nbelzer/Split-Flap-Display/pcb/SplitFlap.kicad_pcb

## KiCad design pcb/SplitFlap.kicad_pcb (2026-03-01)

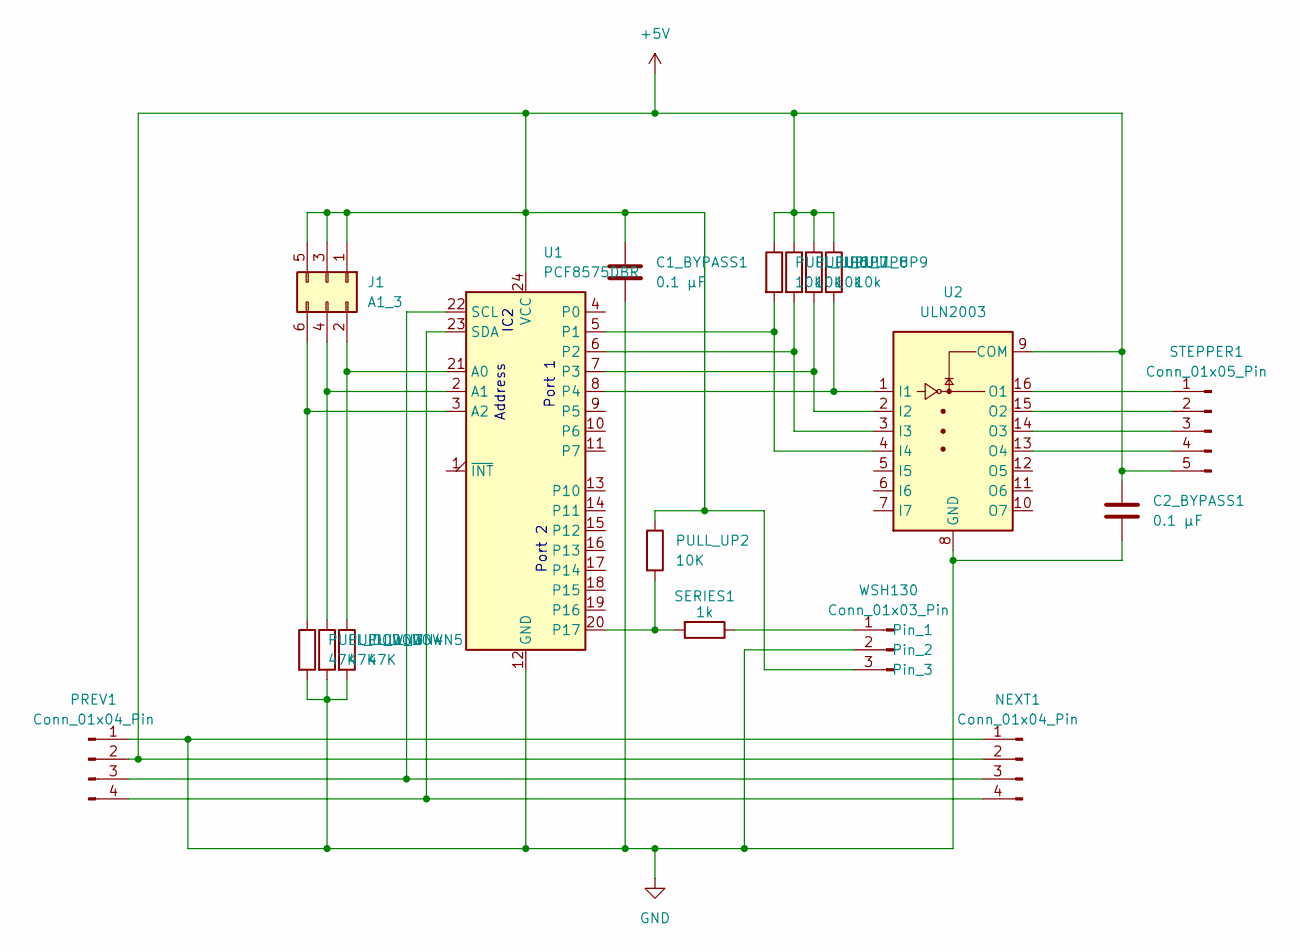
[picture p1: schematic SplitFlap.kicad_sch]

Parts:
C1_BYPASS1, C2_BYPASS1: 0.1 µF; C_0402_1005Metric; MPN C1525
J1: A1_3; PinHeader_2x03_P2.54mm_Vertical; MPN C7501594
NEXT1: Conn_01x04_Pin; PinSocket_1x04_P2.54mm_Horizontal; MPN C2897386
PREV1: Conn_01x04_Pin; PinHeader_1x04_P2.54mm_Horizontal; MPN C91552
PULL_DOWN3, PULL_DOWN4, PULL_DOWN5: 47K; R_0603_1608Metric; MPN C25600
PULL_UP2: 10K; R_0603_1608Metric; MPN C73809
PULL_UP6, PULL_UP7, PULL_UP8, PULL_UP9: 10k; R_0603_1608Metric; MPN C73809
SERIES1: 1k; R_0603_1608Metric; MPN C14676
STEPPER1: Conn_01x05_Pin; JST_XH_S5B-XH-A_1x05_P2.50mm_Horizontal; MPN C263757
U1: PCF8575DBR; SSOP-24_5.3x8.2mm_P0.65mm; MPN C2863388
U2: ULN2003; SOIC-16_3.9x9.9mm_P1.27mm; MPN C61273
WSH130: Conn_01x03_Pin; JST_PH_B3B-PH-K_1x03_P2.00mm_Vertical; MPN C2320

Connections:
+5V: C1_BYPASS1.1, C2_BYPASS1.2, J1.1, J1.3, J1.5, NEXT1.2, PREV1.2, PULL_UP2.1, PULL_UP6.1, PULL_UP7.1, PULL_UP8.1, PULL_UP9.1, STEPPER1.5, U1.24 (VCC), U2.9 (COM), WSH130.3
GND: C1_BYPASS1.2, C2_BYPASS1.1, NEXT1.1, PREV1.1, PULL_DOWN3.2, PULL_DOWN4.2, PULL_DOWN5.2, U1.12 (GND), U2.8 (GND), WSH130.2
unnamed: J1.2, PULL_DOWN5.1, U1.21 (A0)
unnamed: J1.4, PULL_DOWN4.1, U1.2 (A1)
unnamed: J1.6, PULL_DOWN3.1, U1.3 (A2)
unnamed: NEXT1.3, PREV1.3, U1.22 (SCL)
unnamed: NEXT1.4, PREV1.4, U1.23 (SDA)
unnamed: STEPPER1.1, U2.16 (O1)
unnamed: STEPPER1.2, U2.15 (O2)
unnamed: STEPPER1.3, U2.14 (O3)
unnamed: STEPPER1.4, U2.13 (O4)
unnamed: PULL_UP6.2, U1.5 (P1), U2.4 (I4)
unnamed: PULL_UP7.2, U1.6 (P2), U2.3 (I3)
unnamed: PULL_UP8.2, U1.7 (P3), U2.2 (I2)
unnamed: PULL_UP9.2, U1.8 (P4), U2.1 (I1)
unnamed: PULL_UP2.2, SERIES1.2, U1.20 (P17)
unnamed: SERIES1.1, WSH130.1

Notes on the sheet:
Port 2
Address
Port 1
IC2

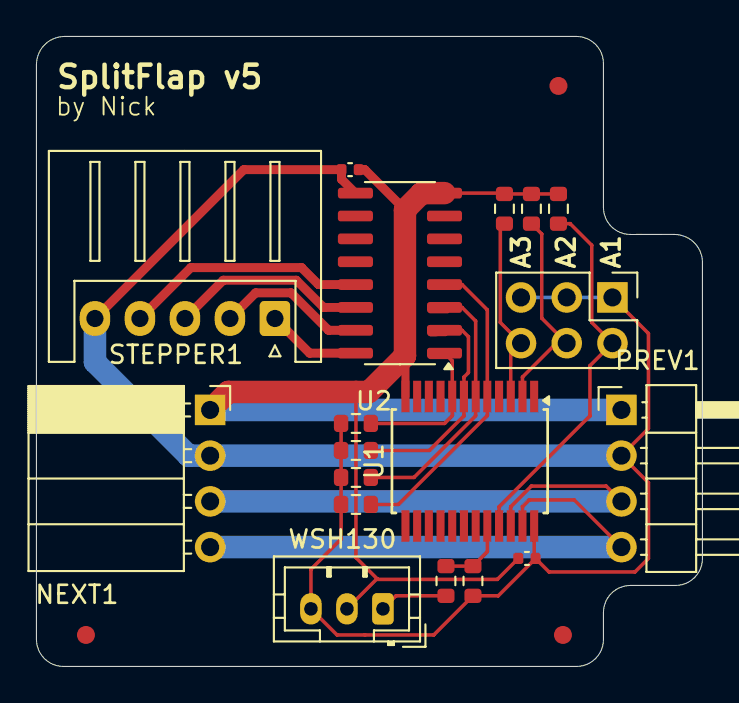
[picture p2: board SplitFlap.kicad_pcb from above]

Board: 2 copper layers, 37.0 x 35.0 mm, 18 parts (0 on the bottom side), 17 nets.
