nbelzer/Split-Flap-Display/(commit log)

2025-04-30 Add 3.3v line for PCF8575
    [SplitFlap.kicad_sch]
2025-05-07 Use two pin address connectors with pulldown resistor
    [SplitFlap.kicad_sch]
2025-05-07 Replace linear regulator with AP2112K
    This regulator has a smaller footprint and seems to be better
    optimised for our use case (more efficient, lower idle power draw,
    less heat).
    [SplitFlap.kicad_sch]
2025-05-07 Accomodate linear regulator and new address pins on PCB
    [SplitFlap.kicad_pcb]
2025-05-07 Add missing part numbers
    [SplitFlap.kicad_sch]
2025-05-07 Minor pcb changes
    - Updates the position of the entire board down,
    - Adds an edge cut section for the WSH130 wiring.
    - Moves the ULN2003 up a bit to clean up the connections.
    - Updates silkscreen labels.
    [SplitFlap.kicad_pcb]
2025-05-07 Add missing part number for address pins
    [SplitFlap.kicad_pcb, SplitFlap.kicad_sch]
2025-05-15 Correct AP2112K capacitors
    [SplitFlap.kicad_sch]
2025-05-28 Add pull-ups between PCF8575 and ULN2003
    This is necessary since the PCF8575 can only pull the output to 0, not
    bring it up to 3.3v, so a pull-up is necessary to communicate with the
    ULN2003 (which only responds to values 2.5v or above).
    [SplitFlap.kicad_sch]
2025-06-03 Use 2x3 connector for address pins
    Saves on board space and component count
    [SplitFlap.kicad_sch]
2025-06-03 Rewire PCB
    [SplitFlap.kicad_pcb]
2025-10-11 Eliminate 3.3v line from PCB
    Based on the findings by FoxManJ the 3.3v line is not required if we
    use a 4.7k Ohm pull-up to 5v for the SCL and SDA lines coming from the
    ESP32.
    By using this pull-up to 5V we eliminate the need for the PCF8575 to
    run at 3.3v to understand the signals from the ESP32, which was the
    reason I originally implemented the 3.3v line on each board.
    [SplitFlap.kicad_pcb, SplitFlap.kicad_sch]
2025-10-11 Use pinsocket and headers for board to board connector
    Eliminates the JST cables between boards.
    [SplitFlap.kicad_pcb, SplitFlap.kicad_sch]
2025-11-14 Update pin and header parts
    [SplitFlap.kicad_pcb]
2025-11-16 Add optional data lines pull-up
    Required as the ESP32 by default does not pull up the data lines to
    5v. Should only be activated once per circuit (display).
    [SplitFlap.kicad_pcb, SplitFlap.kicad_sch]
2025-11-16 Rename pull-up jumper
    [SplitFlap.kicad_pcb, SplitFlap.kicad_sch]
2026-02-09 Fix floating pull-ups
    The optional pull-ups added in v4 added an unintentional floating node
    that would tie SCL and SDA together whenever the pull-up pad was
    unsoldered. Causing the I2C bus to fail (surprisingly only after
    connecting 3 modules).
    [SplitFlap.kicad_pcb, SplitFlap.kicad_sch]
2026-03-01 Remove pull-ups entirely
    For now manually soldering pull-ups to the ESP32 remain an easier solution.
    [SplitFlap.kicad_pcb, SplitFlap.kicad_sch]
2026-03-01 Extend PCB to 37mm
    [SplitFlap.kicad_pcb]
2026-03-01 Bump printed version number
    [SplitFlap.kicad_pcb]
